adafruit/Adafruit-EyeLights-LED-Glasses-and-Driver-PCB/Adafruit EyeLights LED Glasses.brd

## EAGLE design Adafruit EyeLights LED Glasses.brd (2021-10-05)

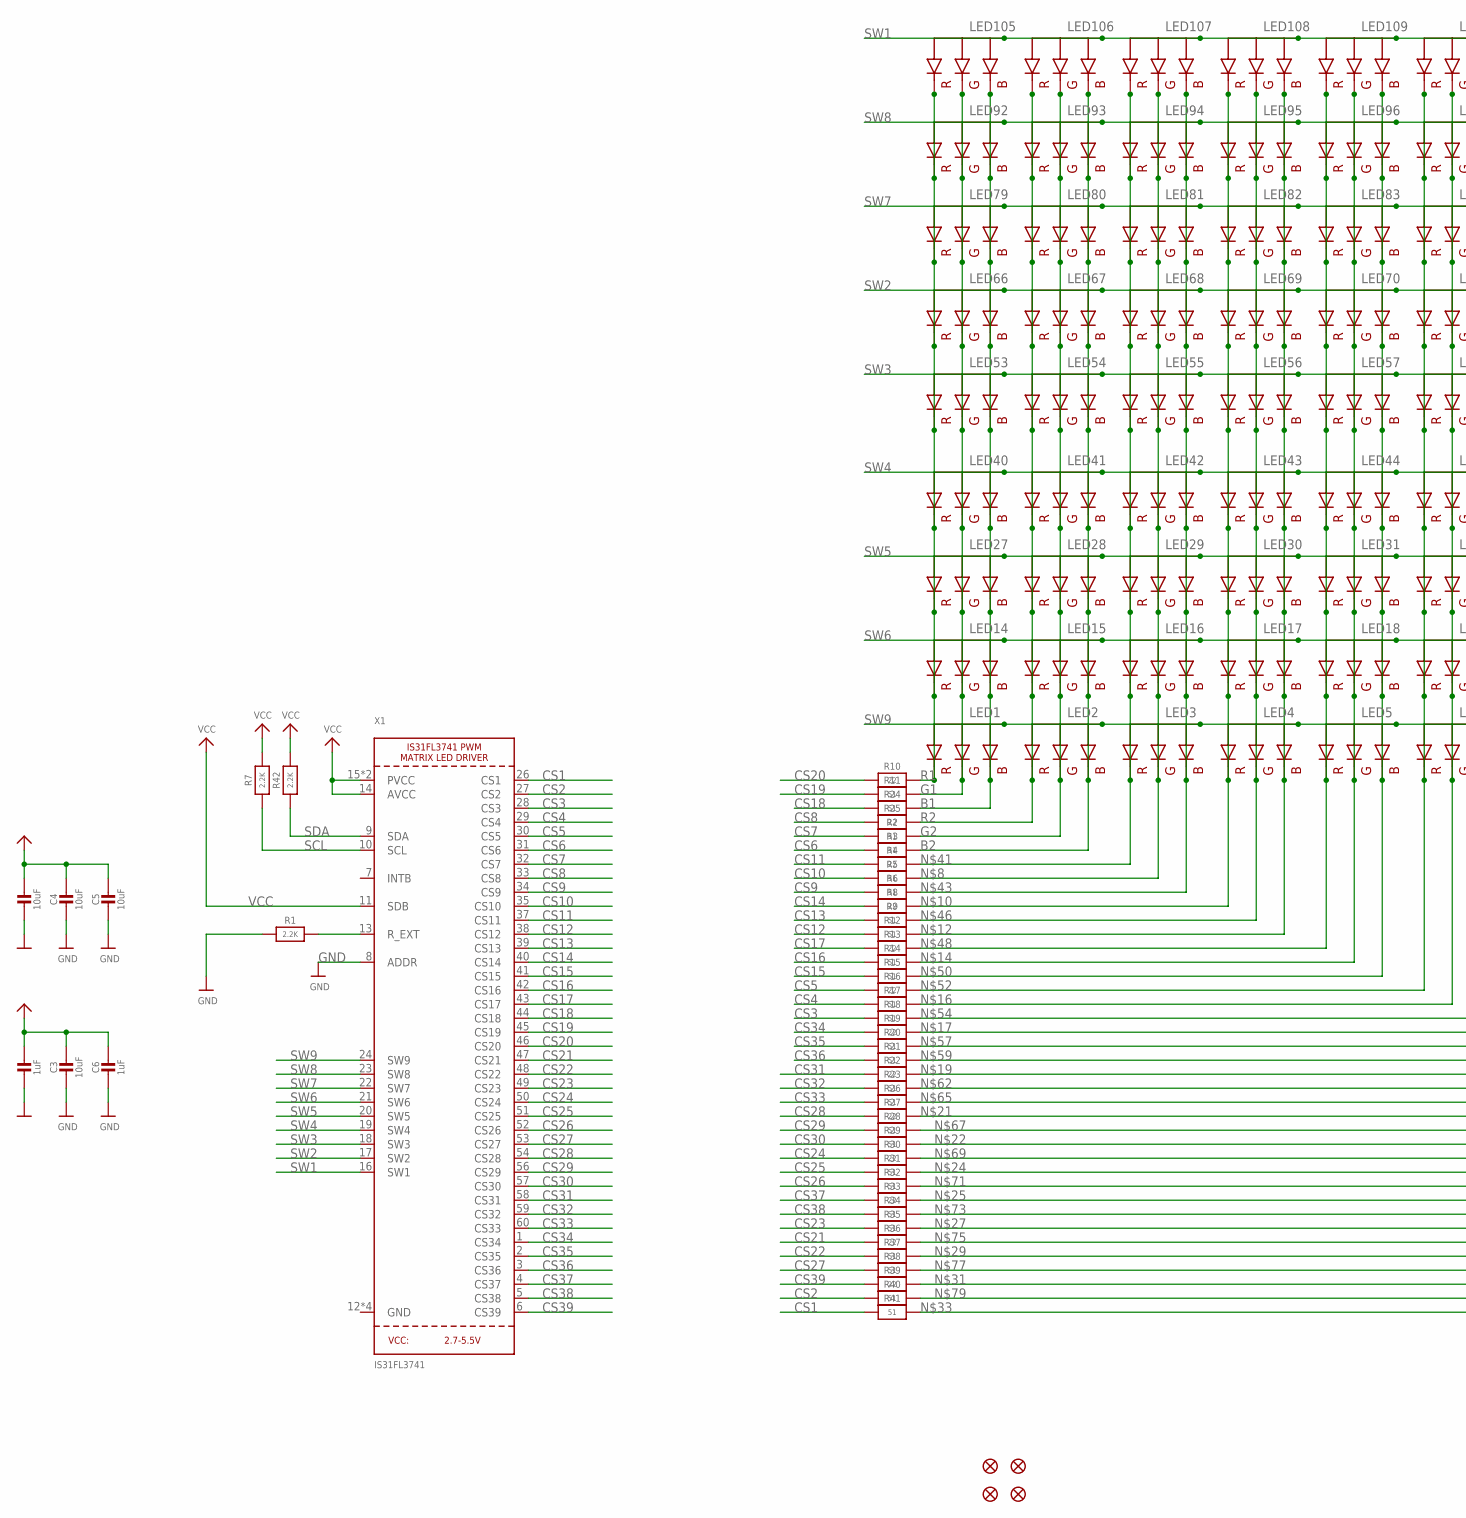
[picture p3: schematic Adafruit EyeLights LED Glasses.sch, part in row 1, column 1]

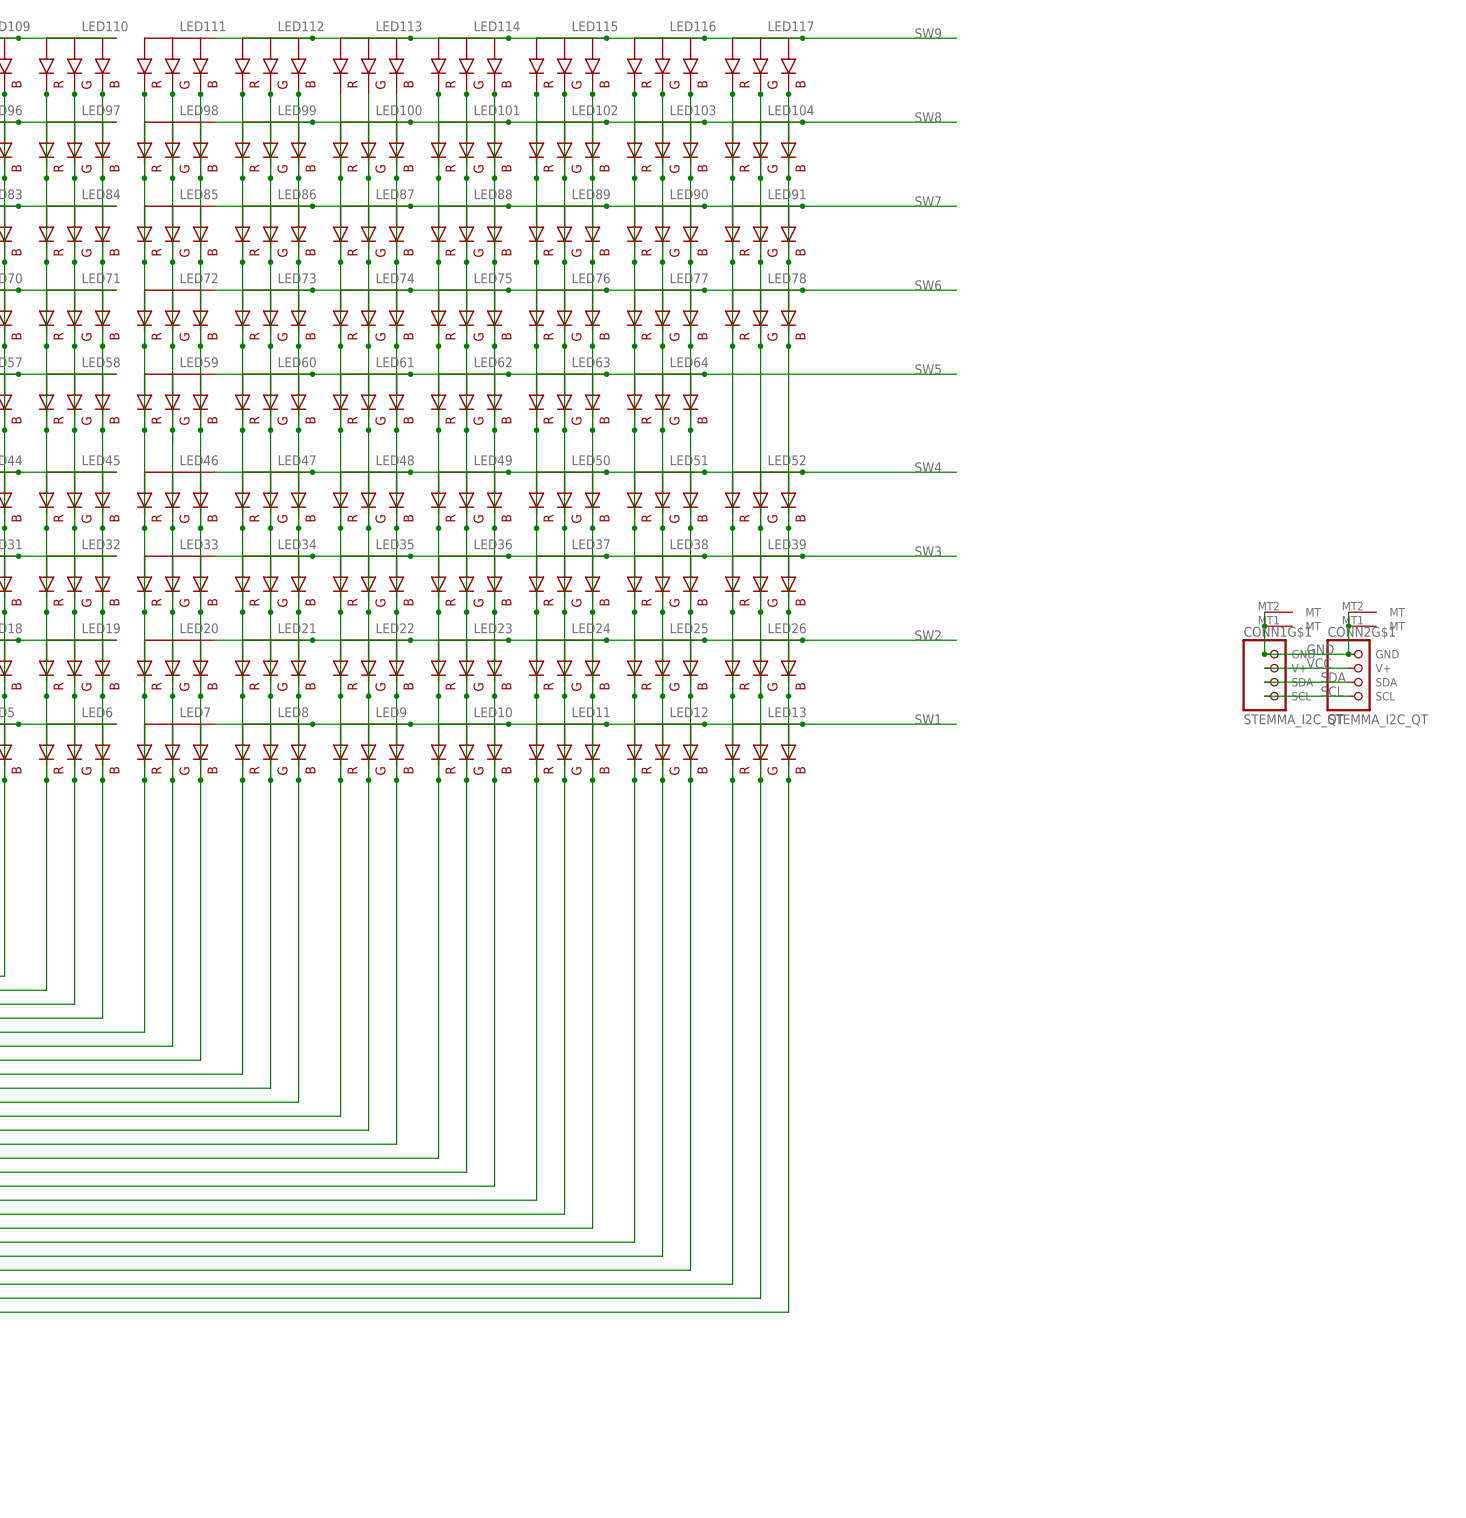
[picture p4: schematic Adafruit EyeLights LED Glasses.sch, part in row 1, column 2]

Parts:
C1, C3, C4, C5: 10uF; 0805-NO
C2, C6: 1uF; 0603-NO
CONN1, CONN2: STEMMA_I2C_QT; JST_SH4
FID1, FID2, FID3, FID4: FIDUCIAL_1MM
LED1, LED2, LED3, LED4, LED5, LED6, LED7, LED8, LED9, LED10, LED11, LED12, LED13, LED14, LED15, LED16, LED17, LED18, LED19, LED20, LED21, LED22, LED23, LED24, LED25, LED26, LED27, LED28, LED29, LED30, LED31, LED32, LED33, LED34, LED35, LED36, LED37, LED38, LED39, LED40, LED41, LED42, LED43, LED44, LED45, LED46, LED47, LED48, LED49, LED50, LED51, LED52, LED53, LED54, LED55, LED56, LED57, LED58, LED59, LED60, LED61, LED62, LED63, LED64, LED66, LED67, LED68, LED69, LED70, LED71, LED72, LED73, LED74, LED75, LED76, LED77, LED78, LED79, LED80, LED81, LED82, LED83, LED84, LED85, LED86, LED87, LED88, LED89, LED90, LED91, LED92, LED93, LED94, LED95, LED96, LED97, LED98, LED99, LED100, LED101, LED102, LED103, LED104, LED105, LED106, LED107, LED108, LED109, LED110, LED111, LED112, LED113, LED114, LED115, LED116, LED117: RGBLED_CA_2121; RGBLED_2121
R1, R7, R42: 2.2K; 0603-NO
R2, R3, R5, R6, R9, R11, R12, R14, R15, R17, R18, R20, R21, R23, R24, R26, R28, R29, R31, R32, R34, R35, R37, R38, R40, R41: 51; 0603-NO
R4, R8, R10, R13, R16, R19, R22, R25, R27, R30, R33, R36, R39: 22; 0603-NO
X1: IS31FL3741; QFN60_7MM

Connections:
B1: LED1.B (BLUE), LED14.B (BLUE), LED27.B (BLUE), LED40.B (BLUE), LED53.B (BLUE), LED66.B (BLUE), LED79.B (BLUE), LED92.B (BLUE), LED105.B (BLUE), R24.2
B2: LED2.B (BLUE), LED15.B (BLUE), LED28.B (BLUE), LED41.B (BLUE), LED54.B (BLUE), LED67.B (BLUE), LED80.B (BLUE), LED93.B (BLUE), LED106.B (BLUE), R3.2
CS1: R41.1, X1.26 (CS1)
CS2: R40.1, X1.27 (CS2)
CS3: R18.1, X1.28 (CS3)
CS4: R17.1, X1.29 (CS4)
CS5: R16.1, X1.30 (CS5)
CS6: R3.1, X1.31 (CS6)
CS7: R2.1, X1.32 (CS7)
CS8: R25.1, X1.33 (CS8)
CS9: R6.1, X1.34 (CS9)
CS10: R5.1, X1.35 (CS10)
CS11: R4.1, X1.37 (CS11)
CS12: R12.1, X1.38 (CS12)
CS13: R9.1, X1.39 (CS13)
CS14: R8.1, X1.40 (CS14)
CS15: R15.1, X1.41 (CS15)
CS16: R14.1, X1.42 (CS16)
CS17: R13.1, X1.43 (CS17)
CS18: R24.1, X1.44 (CS18)
CS19: R11.1, X1.45 (CS19)
CS20: R10.1, X1.46 (CS20)
CS21: R36.1, X1.47 (CS21)
CS22: R37.1, X1.48 (CS22)
CS23: R35.1, X1.49 (CS23)
CS24: R30.1, X1.50 (CS24)
CS25: R31.1, X1.51 (CS25)
CS26: R32.1, X1.52 (CS26)
CS27: R38.1, X1.53 (CS27)
CS28: R27.1, X1.54 (CS28)
CS29: R28.1, X1.56 (CS29)
CS30: R29.1, X1.57 (CS30)
CS31: R22.1, X1.58 (CS31)
CS32: R23.1, X1.59 (CS32)
CS33: R26.1, X1.60 (CS33)
CS34: R19.1, X1.1 (CS34)
CS35: R20.1, X1.2 (CS35)
CS36: R21.1, X1.3 (CS36)
CS37: R33.1, X1.4 (CS37)
CS38: R34.1, X1.5 (CS38)
CS39: R39.1, X1.6 (CS39)
G1: LED1.G (GREEN), LED14.G (GREEN), LED27.G (GREEN), LED40.G (GREEN), LED53.G (GREEN), LED66.G (GREEN), LED79.G (GREEN), LED92.G (GREEN), LED105.G (GREEN), R11.2
G2: LED2.G (GREEN), LED15.G (GREEN), LED28.G (GREEN), LED41.G (GREEN), LED54.G (GREEN), LED67.G (GREEN), LED80.G (GREEN), LED93.G (GREEN), LED106.G (GREEN), R2.2
GND: C1.2, C2.2, C3.2, C4.2, C5.2, C6.2, CONN1.1 (GND), CONN1.MT1 (MT), CONN1.MT2 (MT), CONN2.1 (GND), CONN2.MT1 (MT), CONN2.MT2 (MT), R1.1, X1.8 (ADDR), X1.12 (GND), X1.36 (GND), X1.55 (GND), X1.THERMAL (GND)
unnamed: R1.2, X1.13 (R_EXT)
unnamed: LED3.G (GREEN), LED16.G (GREEN), LED29.G (GREEN), LED42.G (GREEN), LED55.G (GREEN), LED68.G (GREEN), LED81.G (GREEN), LED94.G (GREEN), LED107.G (GREEN), R5.2
unnamed: LED4.R (RED), LED17.R (RED), LED30.R (RED), LED43.R (RED), LED56.R (RED), LED69.R (RED), LED82.R (RED), LED95.R (RED), LED108.R (RED), R8.2
unnamed: LED4.B (BLUE), LED17.B (BLUE), LED30.B (BLUE), LED43.B (BLUE), LED56.B (BLUE), LED69.B (BLUE), LED82.B (BLUE), LED95.B (BLUE), LED108.B (BLUE), R12.2
unnamed: LED5.G (GREEN), LED18.G (GREEN), LED31.G (GREEN), LED44.G (GREEN), LED57.G (GREEN), LED70.G (GREEN), LED83.G (GREEN), LED96.G (GREEN), LED109.G (GREEN), R14.2
unnamed: LED6.G (GREEN), LED19.G (GREEN), LED32.G (GREEN), LED45.G (GREEN), LED58.G (GREEN), LED71.G (GREEN), LED84.G (GREEN), LED97.G (GREEN), LED110.G (GREEN), R17.2
unnamed: LED7.R (RED), LED20.R (RED), LED33.R (RED), LED46.R (RED), LED59.R (RED), LED72.R (RED), LED85.R (RED), LED98.R (RED), LED111.R (RED), R19.2
unnamed: LED8.R (RED), LED21.R (RED), LED34.R (RED), LED47.R (RED), LED60.R (RED), LED73.R (RED), LED86.R (RED), LED99.R (RED), LED112.R (RED), R22.2
unnamed: LED9.R (RED), LED22.R (RED), LED35.R (RED), LED48.R (RED), LED61.R (RED), LED74.R (RED), LED87.R (RED), LED100.R (RED), LED113.R (RED), R27.2
unnamed: LED9.B (BLUE), LED22.B (BLUE), LED35.B (BLUE), LED48.B (BLUE), LED61.B (BLUE), LED74.B (BLUE), LED87.B (BLUE), LED100.B (BLUE), LED113.B (BLUE), R29.2
unnamed: LED10.G (GREEN), LED23.G (GREEN), LED36.G (GREEN), LED49.G (GREEN), LED62.G (GREEN), LED75.G (GREEN), LED88.G (GREEN), LED101.G (GREEN), LED114.G (GREEN), R31.2
unnamed: LED11.R (RED), LED24.R (RED), LED37.R (RED), LED50.R (RED), LED63.R (RED), LED76.R (RED), LED89.R (RED), LED102.R (RED), LED115.R (RED), R33.2
unnamed: LED11.B (BLUE), LED24.B (BLUE), LED37.B (BLUE), LED50.B (BLUE), LED63.B (BLUE), LED76.B (BLUE), LED89.B (BLUE), LED102.B (BLUE), LED115.B (BLUE), R35.2
unnamed: LED12.G (GREEN), LED25.G (GREEN), LED38.G (GREEN), LED51.G (GREEN), LED64.G (GREEN), LED77.G (GREEN), LED90.G (GREEN), LED103.G (GREEN), LED116.G (GREEN), R37.2
unnamed: LED13.R (RED), LED26.R (RED), LED39.R (RED), LED52.R (RED), LED78.R (RED), LED91.R (RED), LED104.R (RED), LED117.R (RED), R39.2
unnamed: LED13.B (BLUE), LED26.B (BLUE), LED39.B (BLUE), LED52.B (BLUE), LED78.B (BLUE), LED91.B (BLUE), LED104.B (BLUE), LED117.B (BLUE), R41.2
unnamed: LED3.R (RED), LED16.R (RED), LED29.R (RED), LED42.R (RED), LED55.R (RED), LED68.R (RED), LED81.R (RED), LED94.R (RED), LED107.R (RED), R4.2
unnamed: LED3.B (BLUE), LED16.B (BLUE), LED29.B (BLUE), LED42.B (BLUE), LED55.B (BLUE), LED68.B (BLUE), LED81.B (BLUE), LED94.B (BLUE), LED107.B (BLUE), R6.2
unnamed: LED4.G (GREEN), LED17.G (GREEN), LED30.G (GREEN), LED43.G (GREEN), LED56.G (GREEN), LED69.G (GREEN), LED82.G (GREEN), LED95.G (GREEN), LED108.G (GREEN), R9.2
unnamed: LED5.R (RED), LED18.R (RED), LED31.R (RED), LED44.R (RED), LED57.R (RED), LED70.R (RED), LED83.R (RED), LED96.R (RED), LED109.R (RED), R13.2
unnamed: LED5.B (BLUE), LED18.B (BLUE), LED31.B (BLUE), LED44.B (BLUE), LED57.B (BLUE), LED70.B (BLUE), LED83.B (BLUE), LED96.B (BLUE), LED109.B (BLUE), R15.2
unnamed: LED6.R (RED), LED19.R (RED), LED32.R (RED), LED45.R (RED), LED58.R (RED), LED71.R (RED), LED84.R (RED), LED97.R (RED), LED110.R (RED), R16.2
unnamed: LED6.B (BLUE), LED19.B (BLUE), LED32.B (BLUE), LED45.B (BLUE), LED58.B (BLUE), LED71.B (BLUE), LED84.B (BLUE), LED97.B (BLUE), LED110.B (BLUE), R18.2
unnamed: LED7.G (GREEN), LED20.G (GREEN), LED33.G (GREEN), LED46.G (GREEN), LED59.G (GREEN), LED72.G (GREEN), LED85.G (GREEN), LED98.G (GREEN), LED111.G (GREEN), R20.2
unnamed: LED7.B (BLUE), LED20.B (BLUE), LED33.B (BLUE), LED46.B (BLUE), LED59.B (BLUE), LED72.B (BLUE), LED85.B (BLUE), LED98.B (BLUE), LED111.B (BLUE), R21.2
unnamed: LED8.G (GREEN), LED21.G (GREEN), LED34.G (GREEN), LED47.G (GREEN), LED60.G (GREEN), LED73.G (GREEN), LED86.G (GREEN), LED99.G (GREEN), LED112.G (GREEN), R23.2
unnamed: LED8.B (BLUE), LED21.B (BLUE), LED34.B (BLUE), LED47.B (BLUE), LED60.B (BLUE), LED73.B (BLUE), LED86.B (BLUE), LED99.B (BLUE), LED112.B (BLUE), R26.2
unnamed: LED9.G (GREEN), LED22.G (GREEN), LED35.G (GREEN), LED48.G (GREEN), LED61.G (GREEN), LED74.G (GREEN), LED87.G (GREEN), LED100.G (GREEN), LED113.G (GREEN), R28.2
unnamed: LED10.R (RED), LED23.R (RED), LED36.R (RED), LED49.R (RED), LED62.R (RED), LED75.R (RED), LED88.R (RED), LED101.R (RED), LED114.R (RED), R30.2
unnamed: LED10.B (BLUE), LED23.B (BLUE), LED36.B (BLUE), LED49.B (BLUE), LED62.B (BLUE), LED75.B (BLUE), LED88.B (BLUE), LED101.B (BLUE), LED114.B (BLUE), R32.2
unnamed: LED11.G (GREEN), LED24.G (GREEN), LED37.G (GREEN), LED50.G (GREEN), LED63.G (GREEN), LED76.G (GREEN), LED89.G (GREEN), LED102.G (GREEN), LED115.G (GREEN), R34.2
unnamed: LED12.R (RED), LED25.R (RED), LED38.R (RED), LED51.R (RED), LED64.R (RED), LED77.R (RED), LED90.R (RED), LED103.R (RED), LED116.R (RED), R36.2
unnamed: LED12.B (BLUE), LED25.B (BLUE), LED38.B (BLUE), LED51.B (BLUE), LED64.B (BLUE), LED77.B (BLUE), LED90.B (BLUE), LED103.B (BLUE), LED116.B (BLUE), R38.2
unnamed: LED13.G (GREEN), LED26.G (GREEN), LED39.G (GREEN), LED52.G (GREEN), LED78.G (GREEN), LED91.G (GREEN), LED104.G (GREEN), LED117.G (GREEN), R40.2
R1: LED1.R (RED), LED14.R (RED), LED27.R (RED), LED40.R (RED), LED53.R (RED), LED66.R (RED), LED79.R (RED), LED92.R (RED), LED105.R (RED), R10.2
R2: LED2.R (RED), LED15.R (RED), LED28.R (RED), LED41.R (RED), LED54.R (RED), LED67.R (RED), LED80.R (RED), LED93.R (RED), LED106.R (RED), R25.2
SCL: CONN1.4 (SCL), CONN2.4 (SCL), R7.1, X1.10 (SCL)
SDA: CONN1.3 (SDA), CONN2.3 (SDA), R42.1, X1.9 (SDA)
SW1: LED7.A (VCC), LED8.A (VCC), LED9.A (VCC), LED10.A (VCC), LED11.A (VCC), LED12.A (VCC), LED13.A (VCC), LED105.A (VCC), LED106.A (VCC), LED107.A (VCC), LED108.A (VCC), LED109.A (VCC), LED110.A (VCC), X1.16 (SW1)
SW2: LED20.A (VCC), LED21.A (VCC), LED22.A (VCC), LED23.A (VCC), LED24.A (VCC), LED25.A (VCC), LED26.A (VCC), LED66.A (VCC), LED67.A (VCC), LED68.A (VCC), LED69.A (VCC), LED70.A (VCC), LED71.A (VCC), X1.17 (SW2)
SW3: LED33.A (VCC), LED34.A (VCC), LED35.A (VCC), LED36.A (VCC), LED37.A (VCC), LED38.A (VCC), LED39.A (VCC), LED53.A (VCC), LED54.A (VCC), LED55.A (VCC), LED56.A (VCC), LED57.A (VCC), LED58.A (VCC), X1.18 (SW3)
SW4: LED40.A (VCC), LED41.A (VCC), LED42.A (VCC), LED43.A (VCC), LED44.A (VCC), LED45.A (VCC), LED46.A (VCC), LED47.A (VCC), LED48.A (VCC), LED49.A (VCC), LED50.A (VCC), LED51.A (VCC), LED52.A (VCC), X1.19 (SW4)
SW5: LED27.A (VCC), LED28.A (VCC), LED29.A (VCC), LED30.A (VCC), LED31.A (VCC), LED32.A (VCC), LED59.A (VCC), LED60.A (VCC), LED61.A (VCC), LED62.A (VCC), LED63.A (VCC), LED64.A (VCC), X1.20 (SW5)
SW6: LED14.A (VCC), LED15.A (VCC), LED16.A (VCC), LED17.A (VCC), LED18.A (VCC), LED19.A (VCC), LED72.A (VCC), LED73.A (VCC), LED74.A (VCC), LED75.A (VCC), LED76.A (VCC), LED77.A (VCC), LED78.A (VCC), X1.21 (SW6)
SW7: LED79.A (VCC), LED80.A (VCC), LED81.A (VCC), LED82.A (VCC), LED83.A (VCC), LED84.A (VCC), LED85.A (VCC), LED86.A (VCC), LED87.A (VCC), LED88.A (VCC), LED89.A (VCC), LED90.A (VCC), LED91.A (VCC), X1.22 (SW7)
SW8: LED92.A (VCC), LED93.A (VCC), LED94.A (VCC), LED95.A (VCC), LED96.A (VCC), LED97.A (VCC), LED98.A (VCC), LED99.A (VCC), LED100.A (VCC), LED101.A (VCC), LED102.A (VCC), LED103.A (VCC), LED104.A (VCC), X1.23 (SW8)
SW9: LED1.A (VCC), LED2.A (VCC), LED3.A (VCC), LED4.A (VCC), LED5.A (VCC), LED6.A (VCC), LED111.A (VCC), LED112.A (VCC), LED113.A (VCC), LED114.A (VCC), LED115.A (VCC), LED116.A (VCC), LED117.A (VCC), X1.24 (SW9)
VCC: C1.1, C2.1, C3.1, C4.1, C5.1, C6.1, CONN1.2 (V+), CONN2.2 (V+), R7.2, R42.2, X1.11 (SDB), X1.14 (AVCC), X1.15 (PVCC), X1.25 (PVCC)

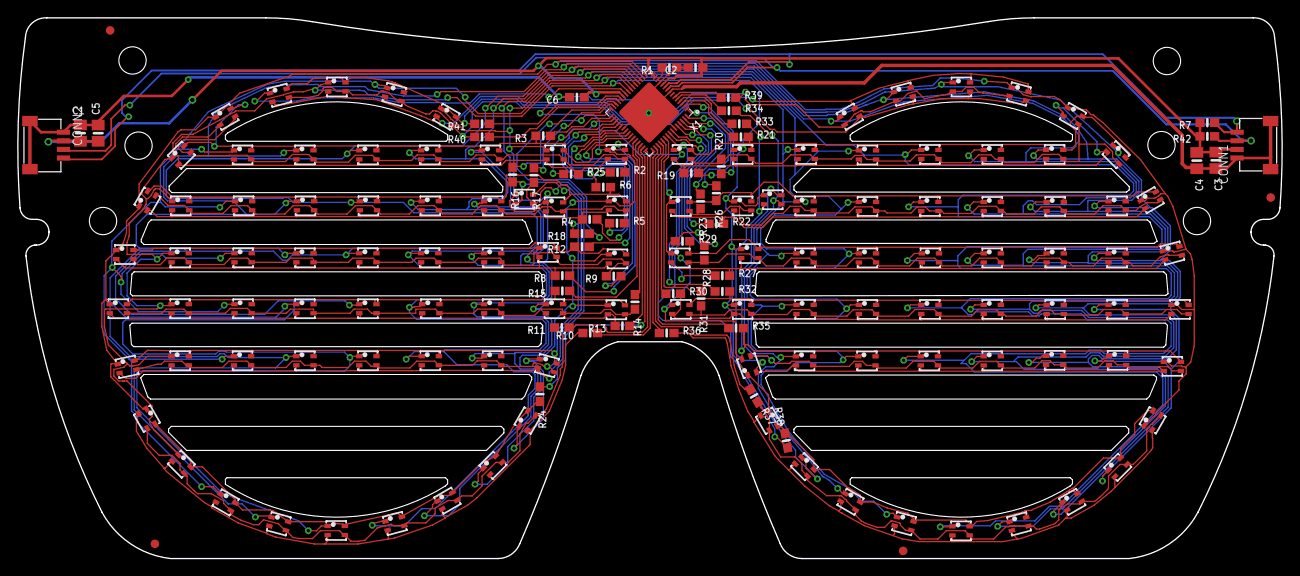
[picture p5: board Adafruit EyeLights LED Glasses.brd from above]

Board: 2 copper layers, 147.0 x 62.9 mm, 171 parts (0 on the bottom side), 92 nets.
