adafruit/Adafruit-EyeLights-LED-Glasses-and-Driver-PCB/Adafruit EyeLights LED Glasses Driver.brd

## EAGLE design Adafruit EyeLights LED Glasses Driver.brd (2021-10-05)

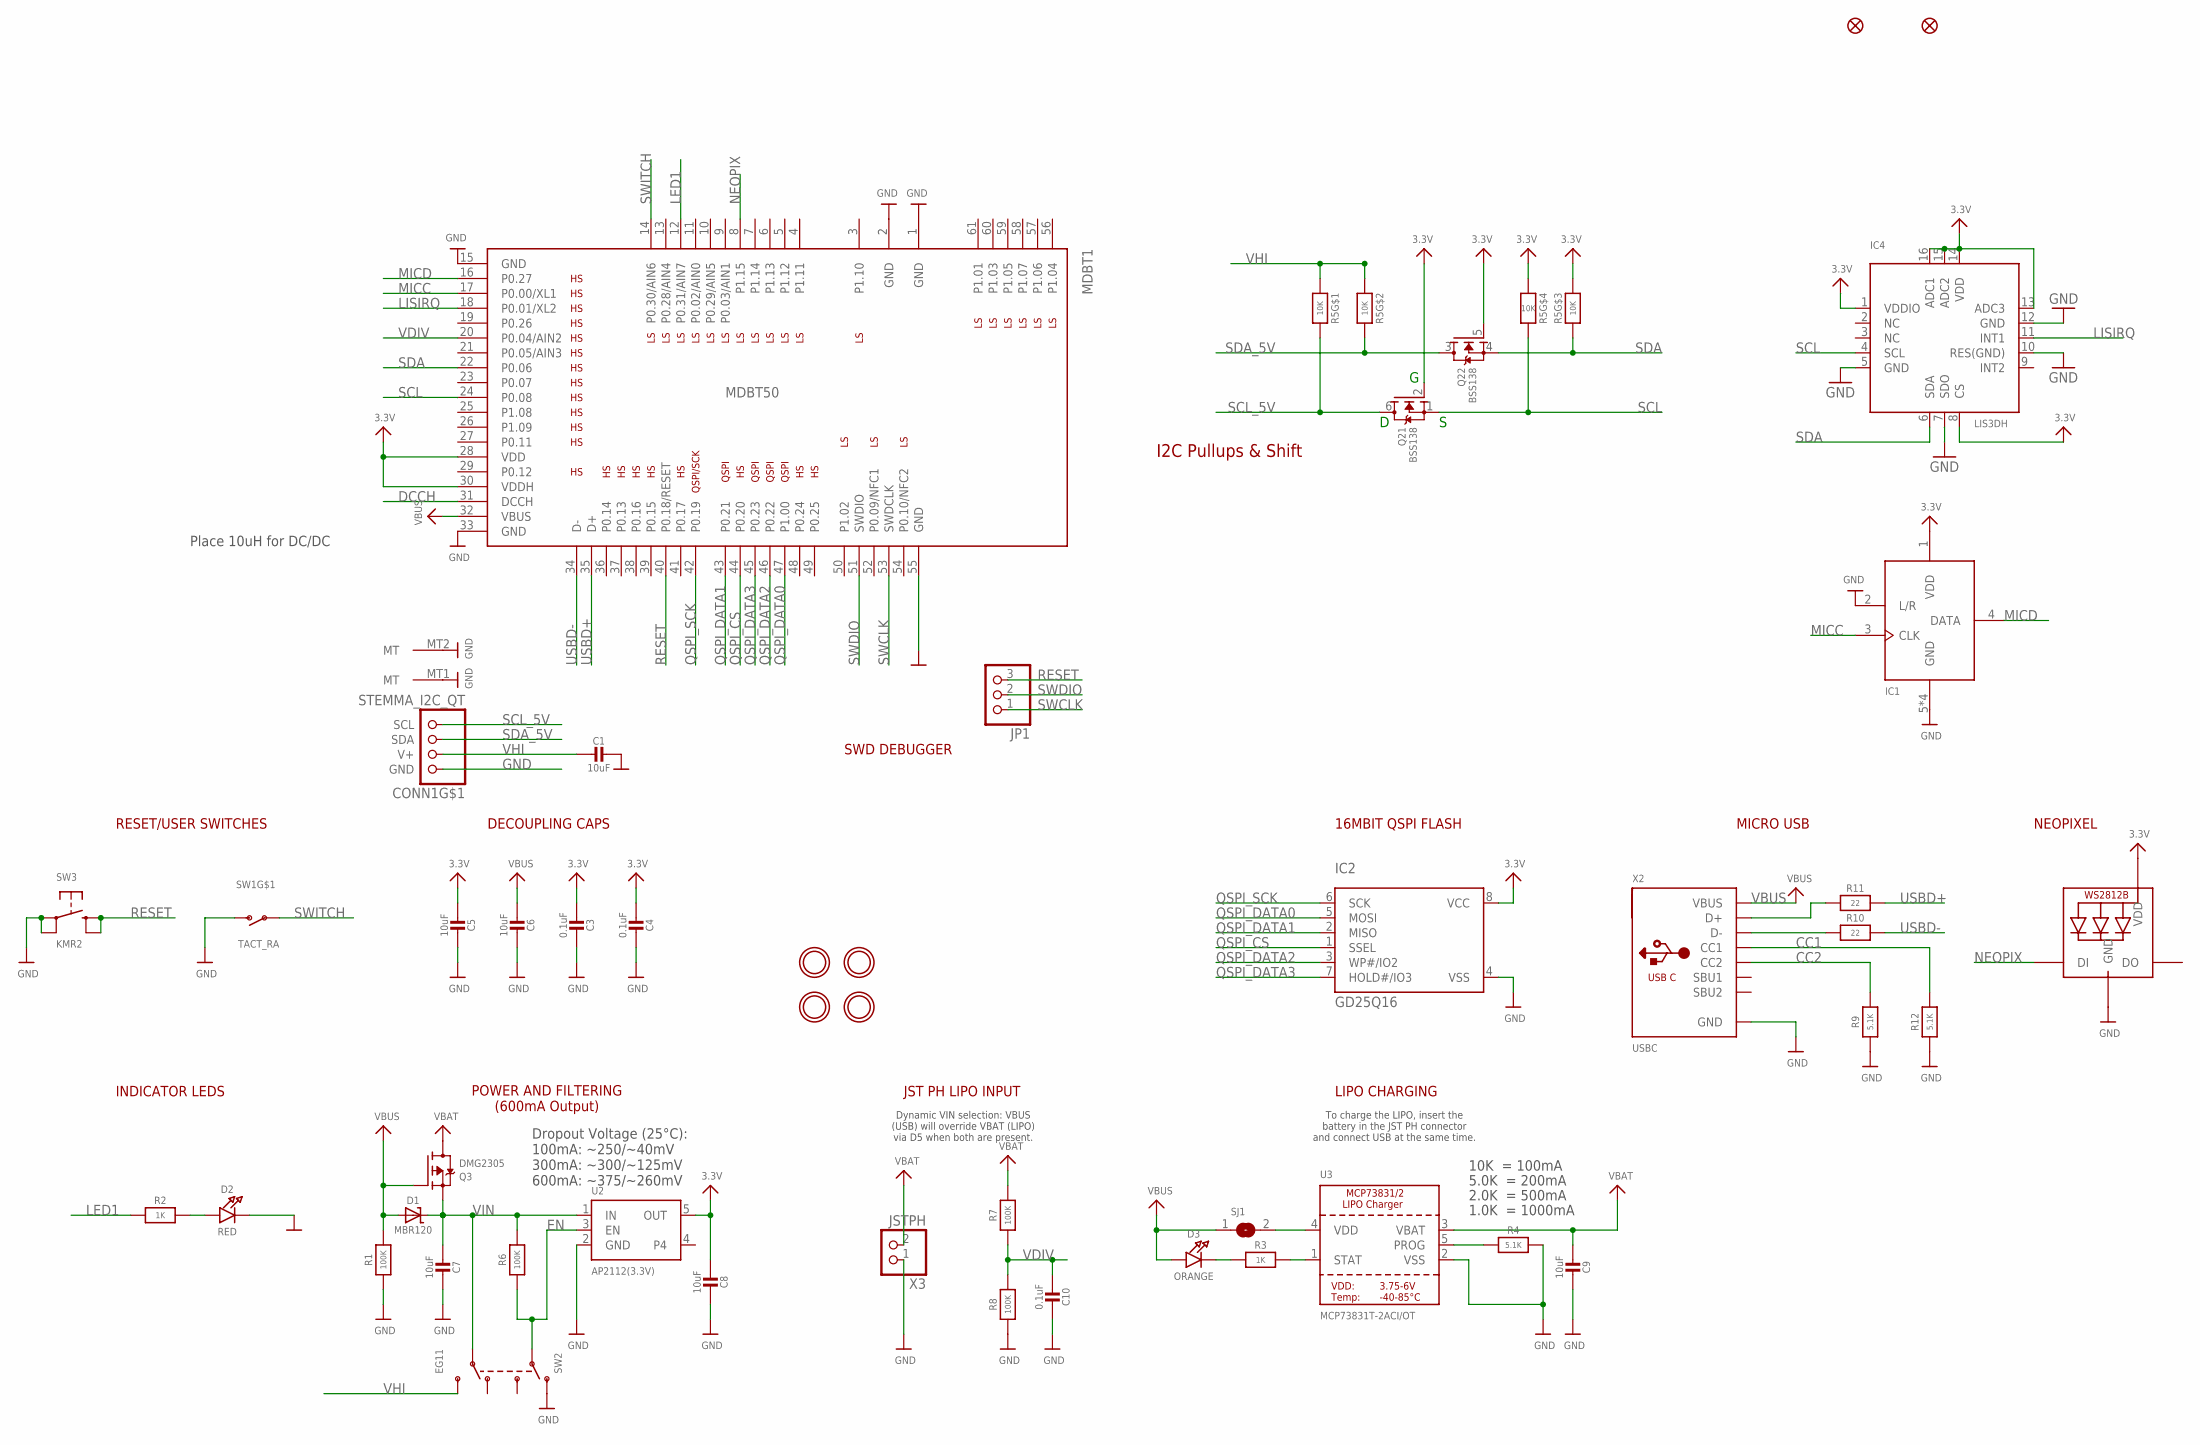
[picture p6: schematic Adafruit EyeLights LED Glasses Driver.sch]

Parts:
C1, C5, C6, C7, C8, C9: 10uF; 0805-NO
C3, C4, C10: 0.1uF; 0603-NO
CONN1: STEMMA_I2C_QT; JST_SH4
D1: MBR120; SOD-123
D2: RED; CHIPLED_0805_NOOUTLINE
D3: ORANGE; CHIPLED_0805_NOOUTLINE
FID1, FID2: FIDUCIAL_1MM
IC1: MIC_PDM_SPK0415; SPK0415HM4H
IC2: GD25Q16; SOIC8_150MIL
IC4: LIS3DH; LGA16_3X3MM
JP1: HEADER-1X3ROUND; 1X03_ROUND
LED1: WS2812B_SK6805_1515; SK6805_1515
MDBT1: MDBT50
Q2: BSS138; SOT363
Q3: DMG2305; SOT23-R
R1, R6, R7, R8: 100K; 0603-NO
R2, R3: 1K; 0603-NO
R4, R9, R12: 5.1K; 0603-NO
R5: 10K; RESPACK_4X0603
R10, R11: 22; 0603-NO
SJ1: SOLDERJUMPER; SOLDERJUMPER_ARROW_NOPASTE
SW1: TACT_RA; SPST_TACTILE_RA
SW2: EG11; EG1390
SW3: KMR2; BTN_KMR2_4.6X2.8
U2: AP2112(3.3V); SOT23-5
U3: MCP73831T-2ACI/OT; SOT23-5
U$10, U$12, U$14, U$16: MOUNTINGHOLE_SLOT4MM; SLOT_4MM_PLATED
X2: USBC; USB_C_CUSB31-CFM2AX-01-X
X3: JSTPH; JSTPH2_BATT

Connections:
3.3V: C3.2, C4.2, C5.2, C8.2, IC1.1 (VDD), IC2.8 (VCC), IC4.1 (VDDIO), IC4.8 (CS), IC4.13 (ADC3), IC4.14 (VDD), IC4.15 (ADC2), IC4.16 (ADC1), LED1.2 (VDD), MDBT1.28 (VDD), MDBT1.30 (VDDH), Q2.2 (G), Q2.5 (G), R5.3 (1), R5.5 (2), U2.5 (OUT)
CC1: R12.2, X2.A5 (CC1)
CC2: R9.2, X2.B5 (CC2)
D+: R11.1, X2.A6 (D+), X2.B6 (D+)
D-: R10.1, X2.A7 (D-), X2.B7 (D-)
DCCH: MDBT1.31 (DCCH)
EN: R6.1, SW2.P1, U2.3 (EN)
GND: C1.1, C3.1, C4.1, C5.1, C6.1, C7.1, C8.1, C9.1, C10.1, CONN1.1 (GND), CONN1.MT1 (MT), CONN1.MT2 (MT), D2.C, IC1.2 (L/R), IC1.5 (GND), IC1.6 (GND), IC1.7 (GND), IC1.8 (GND), IC2.4 (VSS), IC4.5 (GND), IC4.7 (SDO), IC4.10 (RES(GND)), IC4.12 (GND), LED1.4 (GND), MDBT1.1 (GND), MDBT1.2 (GND), MDBT1.15 (GND), MDBT1.33 (GND), MDBT1.55 (GND), R1.1, R4.2, R8.1, R9.1, R12.1, SW1.2 (S), SW2.O1, SW3.A, SW3.A' (P1), U2.2 (GND), U3.2 (VSS), X2.A1B12 (GND), X2.B1A12 (GND), X3.1
LED1: MDBT1.12 (P0.31/AIN7), R2.1
LISIRQ: IC4.11 (INT1), MDBT1.18 (P0.01/XL2)
MICC: IC1.3 (CLK), MDBT1.17 (P0.00/XL1)
MICD: IC1.4 (DATA), MDBT1.16 (P0.27)
unnamed: D3.C, R3.1
unnamed: SJ1.2, U3.4 (VDD)
unnamed: D2.A, R2.2
unnamed: R3.2, U3.1 (STAT)
unnamed: R4.1, U3.5 (PROG)
NEOPIX: LED1.1 (DI), MDBT1.8 (P1.15)
QSPI_CS: IC2.1 (SSEL), MDBT1.44 (P0.20)
QSPI_DATA0: IC2.5 (MOSI), MDBT1.47 (P1.00)
QSPI_DATA1: IC2.2 (MISO), MDBT1.43 (P0.21)
QSPI_DATA2: IC2.3 (WP#/IO2), MDBT1.46 (P0.22)
QSPI_DATA3: IC2.7 (HOLD#/IO3), MDBT1.45 (P0.23)
QSPI_SCK: IC2.6 (SCK), MDBT1.42 (P0.19)
RESET: JP1.3, MDBT1.40 (P0.18/RESET), SW3.B (S), SW3.B' (S1)
SCL: IC4.4 (SCL), MDBT1.24 (P0.08), Q2.1 (S), R5.4 (1)
SCL_5V: CONN1.4 (SCL), Q2.6 (D), R5.8 (2)
SDA: IC4.6 (SDA), MDBT1.22 (P0.06), Q2.4 (S), R5.6 (2)
SDA_5V: CONN1.3 (SDA), Q2.3 (D), R5.7 (2)
SWCLK: JP1.1, MDBT1.53 (SWDCLK)
SWDIO: JP1.2, MDBT1.51 (SWDIO)
SWITCH: MDBT1.14 (P0.30/AIN6), SW1.1
USBD+: MDBT1.35 (D+), R11.2
USBD-: MDBT1.34 (D-), R10.2
VBAT: C9.2, Q3.3 (D), R7.2, U3.3 (VBAT), X3.2
VBUS: C6.2, D1.A, D3.A, MDBT1.32 (VBUS), Q3.1 (G), R1.2, SJ1.1, X2.A4B9 (VBUS), X2.B4A9 (VBUS)
VDIV: C10.2, MDBT1.20 (P0.04/AIN2), R7.1, R8.2
VHI: C1.2, CONN1.2 (V+), R5.1, R5.2 (1), SW2.S2
VIN: C7.2, D1.C, Q3.2 (S), R6.2, SW2.P2, U2.1 (IN)

Notes on the sheet:
10K = 100mA
5.0K = 200mA
2.0K = 500mA
1.0K = 1000mA
LIPO CHARGING
To charge the LIPO, insert the battery in the JST PH connector and connect USB at the same time.
POWER AND FILTERING (600mA Output)
JST PH LIPO INPUT
Dynamic VIN selection: VBUS (USB) will override VBAT (LIPO) via D5 when both are present.
Dropout Voltage (25°C): 100mA: ~250/~40mV 300mA: ~300/~125mV 600mA: ~375/~260mV
INDICATOR LEDS
RESET/USER SWITCHES
DECOUPLING CAPS
SWD DEBUGGER
16MBIT QSPI FLASH
MICRO USB
NEOPIXEL
Place 10uH for DC/DC
I2C Pullups & Shift

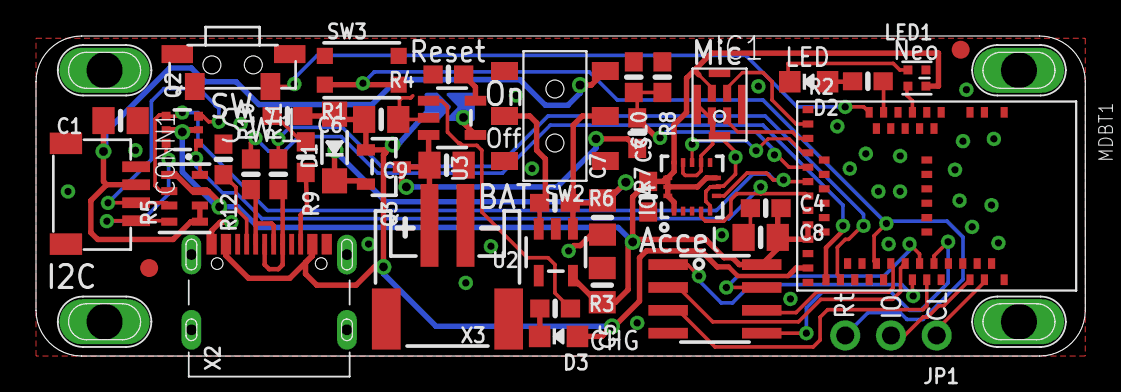
[picture p7: board Adafruit EyeLights LED Glasses Driver.brd from above]

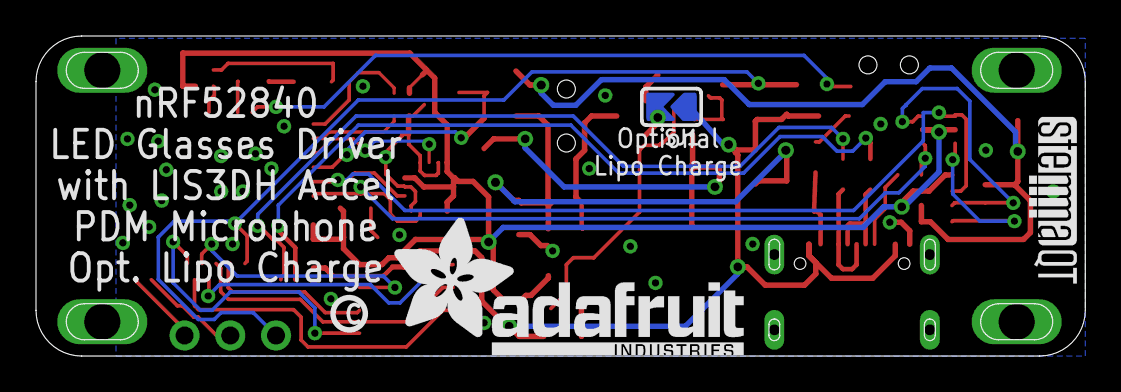
[picture p8: board Adafruit EyeLights LED Glasses Driver.brd from below]

Board: 2 copper layers, 58.3 x 17.8 mm, 50 parts (4 on the bottom side), 38 nets.

Other parts of the board:
U$28: STEMMAQT
U$37: ADAFRUIT_TEXT_20MM
U$63: PCBFEAT-REV-040
